yaddatrance/Laserpooper/PCB/PCBimage.png

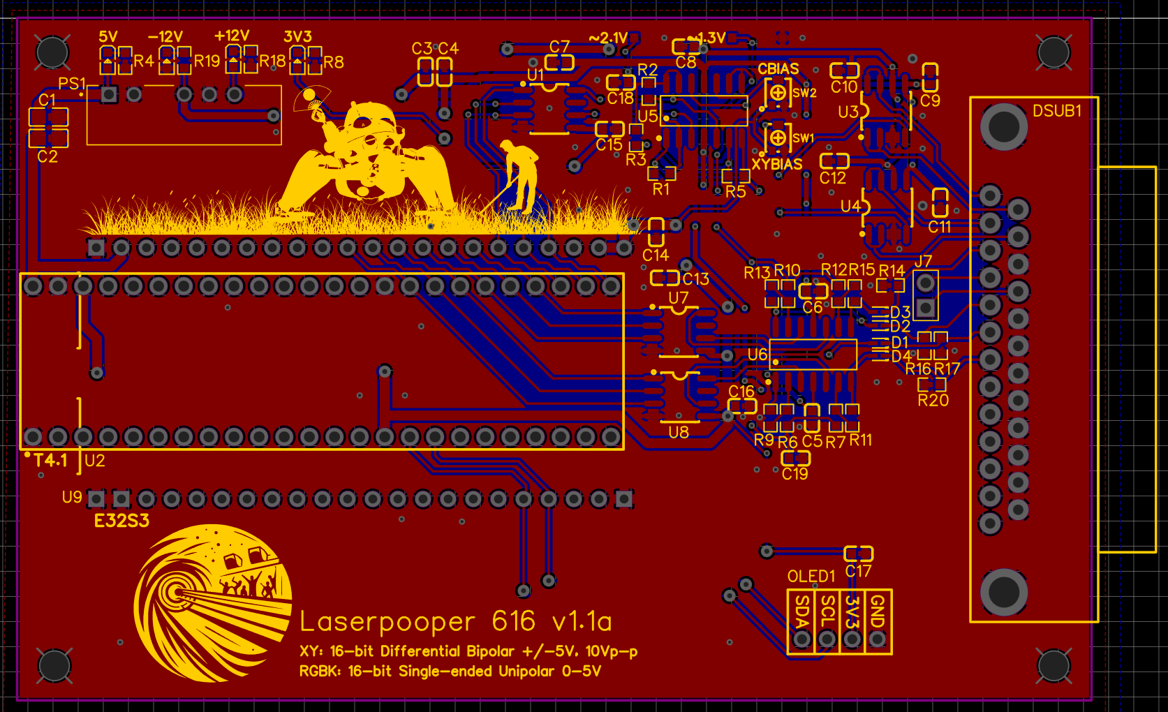
PCB/PCBimage.png
