yaddatrance/Laserpooper/PCB/BOM_ad5359b54c03457ea8222c665098385f.csv

ID | Name | Designator | Footprint | Quantity | Manufacturer Part | Manufacturer | Supplier | Supplier Part | Price | Contributor | link | 3DModel | JLCPCB Part Class
1 | 4.7u | C1,C2 | C0805 | 2 |  | muRata(村田) |  |  |  | LCEDA_Lib | https://item.szlcsc.com/373011.html | C0805_L2.0-W1.3-H1.3
2 | 1u | C3,C4 | C0603 | 2 |  | TAIYO YUDEN(太诱) |  |  |  | LCEDA_Lib | https://item.szlcsc.com/362304.html | C0603_L1.6-W0.8-H0.8
3 | 0.1u | C5,C6,C7,C8,C9,C10,C11,C12,C13,C14,C15,C16,C17 | C0603 | 13 |  | YAGEO(国巨) |  |  |  | LCEDA_Lib | https://item.szlcsc.com/362304.html | C0603_L1.6-W0.8-H0.8
4 | 0.1u | C18,C19 | C0603 | 2 |  |  |  |  |  | LCEDA_Lib | https://item.szlcsc.com/362304.html | C0603_L1.6-W0.8-H0.8
5 | 1N4148WT_C2892576 | D1,D2,D3,D4 | SOD-523_L1.2-W0.8-LS1.6-RD | 4 | 1N4148WT | YONGYUTAI(永裕泰) | LCSC | C2892576 |  | lcsc | https://item.szlcsc.com/10573.html | SOD-523_L1.2-W0.8-H0.7-LS1.6 | Extended Part
6 | 5747846-6 | DSUB1 | 5747846-6 | 1 | 5747846-6 | TE Connectivity | Mouser | 571-5747846-6 |  | rad_aci | https://www.mouser.de/ProductDetail/TE-Connectivity/5747846-6?qs=x6EjVpvqMVMeA4iw%2FpkEDQ%3D%3D
7 | INTERLOCK | J7 | HEADER1X2 | 1 |  | ZHOURI(洲日) |  |  |  | mrw42
8 | KT-0603R | LED1,LED2,LED3,LED4 | LED0603-RD | 4 | KT-0603R | KENTO | LCSC | C2286 |  | lcsc | https://item.szlcsc.com/347874.html | LED0603-RD | Basic Part
9 | 0.96OLED_4P_MODULE_JX | OLED1 | 0.96OLED_4P_KSON | 1 | 0.96OLED_4P_MODULE_JX | null | LCSC | C9900004566 |  | LCSC | https://cn.bing.com/search?q=datasheet：0.96OLED | 0.96OLED_4P | Extended Part
10 | PDME1-S5-D12-S | PS1 | CONV_PDME1-S5-D12-S | 1 |  | CUI Inc. |  |  |  | Dean Netherton
11 | 5.6kΩ | R1,R5 | R0603 | 2 | 0603WAF5601T5E | UNI-ROYAL(厚声) | LCSC | C23189 |  | lcsc | https://www.mouser.in/datasheet/2/447/PYu_RT_1_to_0_01_RoHS_L_11-1669912.pdf | R0603 | Basic Part
12 | 680Ω | R4 | R0603 | 1 | 0603WAF6800T5E | UNI-ROYAL(厚声) | LCSC | C23228 |  | lcsc | https://www.mouser.in/datasheet/2/447/PYu_RT_1_to_0_01_RoHS_L_11-1669912.pdf | R0603 | Basic Part
13 | 10kΩ | R6,R7,R10,R12 | R0603 | 4 | 0603WAF1002T5E | UNI-ROYAL(厚声) | LCSC | C25804 |  | lcsc | https://www.mouser.in/datasheet/2/447/PYu_RT_1_to_0_01_RoHS_L_11-1669912.pdf | R0603 | Basic Part
14 | 300Ω | R8 | R0603 | 1 | 0603WAF3000T5E | UNI-ROYAL(厚声) | LCSC | C23025 |  | lcsc | https://www.mouser.in/datasheet/2/447/PYu_RT_1_to_0_01_RoHS_L_11-1669912.pdf | R0603 | Basic Part
15 | 30kΩ | R9,R11,R13,R15 | R0603 | 4 | 0603WAF3002T5E | UNI-ROYAL(厚声) | LCSC | C22984 |  | lcsc | https://www.mouser.in/datasheet/2/447/PYu_RT_1_to_0_01_RoHS_L_11-1669912.pdf | R0603 | Basic Part
16 | 1kΩ | R2,R3,R14,R16,R17,R20 | R0603 | 6 | 0603WAF1001T5E | UNI-ROYAL(厚声) | LCSC | C21190 |  | lcsc | https://www.mouser.in/datasheet/2/447/PYu_RT_1_to_0_01_RoHS_L_11-1669912.pdf | R0603 | Basic Part
17 | 2.2kΩ | R18,R19 | R0603 | 2 | 0603WAF2201T5E | UNI-ROYAL(厚声) | LCSC | C4190 |  | lcsc | https://www.mouser.in/datasheet/2/447/PYu_RT_1_to_0_01_RoHS_L_11-1669912.pdf | R0603 | Basic Part
18 | 10kΩ | SW1,SW2 | RES-ADJ-SMD_3P-L2.8-W2.4-P1.25 | 2 | ST-2TA103 | NIDEC(尼得科) | LCSC | C2922056 |  | LCSC | https://www.mouser.com/datasheet/2/972/st_2-1827305.pdf | RES-ADJ-SMD_3P-L2.8-W2.4-P1.25 | Extended Part
19 | TEENSY USB BOARD, VERSION 4.1 | U2 | COMM-TH_L61.0-W17.8-P2.54 | 1 | Teensy USB Board, Version 4.1 | null | LCSC | C9900060513 |  | lcsc | https://www.pjrc.com/store/teensy41.html | COMM-TH_L61.0-W17.8-P2.54 | Extended Part
20 | DRV135UA/2K5 | U3,U4 | SOIC-8_L5.0-W4.0-P1.27-LS6.0-BL | 2 | DRV135UA/2K5 | Texas Instruments | LCSC | C544663 |  | Will Schoenfeld | https://item.szlcsc.com/417287.html | SOIC-8_L4.9-W3.9-H1.7-LS6.0-P1.27 | Extended Part
21 | TL074CDT | U5,U6 | SOIC-14_L8.7-W3.9-P1.27-LS6.0-BL | 2 | TL074CDT | ST(意法半导体) | LCSC | C6963 |  | lcsc | https://item.szlcsc.com/7253.html | SOIC-14_L8.6-W3.9-H1.8-LS6.0-P1.27 | Extended Part
22 | TM8211 | U1,U7,U8 | SOIC-8_L5.0-W4.0-P1.27-LS6.0-BL | 3 | TM8211 | TM(天微) | LCSC | C92003 |  | lcsc | https://item.szlcsc.com/417287.html | SOIC-8_L4.9-W3.9-H1.7-LS6.0-P1.27 | Extended Part
23 | ESP32-S3-DEVKITC-1 | U9 | ESP32-S3-DEVKITC-1-KENSONNOSILK | 1 |  |  |  |  |  | billo4th
