yaddatrance/Laserpooper/PCB/Schematic_DACAFTER_2024-07-10.pdf

# GND⁺⁵V

15 10 16 11 17 12 18 13 19 14 20 5V 21 G

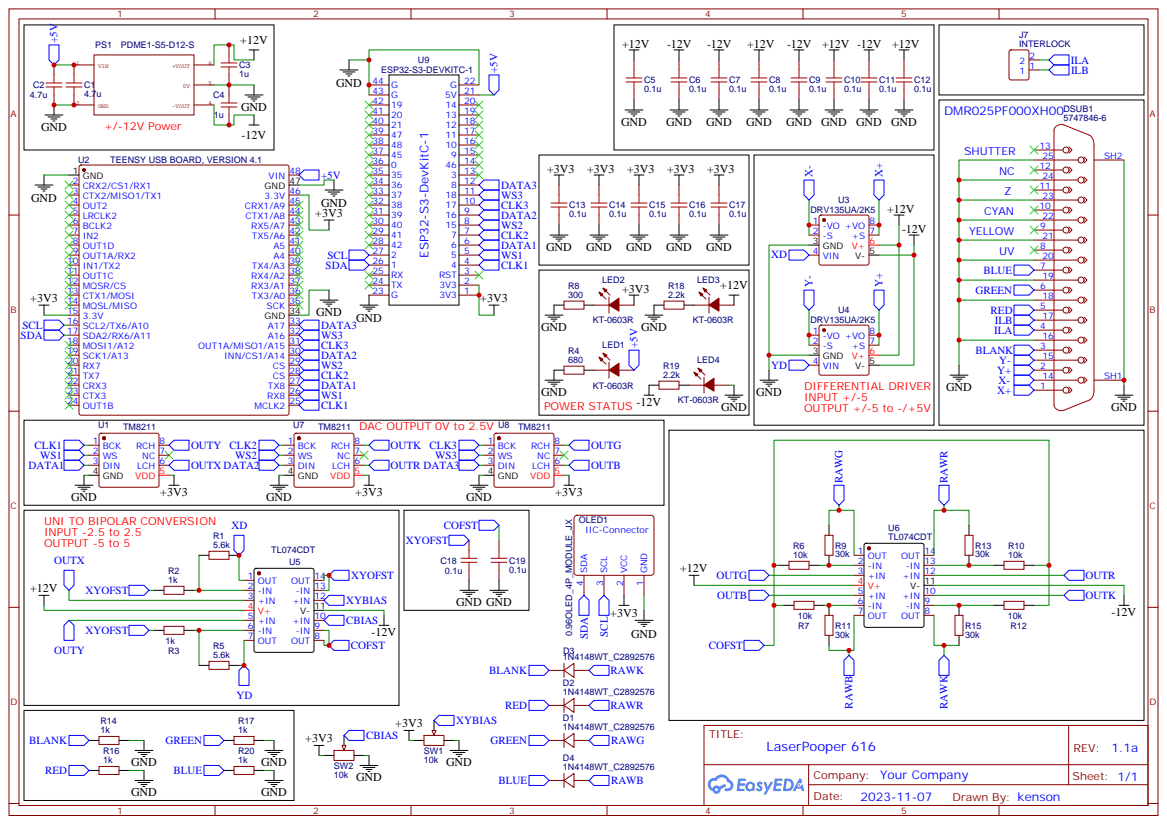
[picture p2: page 1]

UNI TO BIPOLAR CONVERSION
INPUT -2.5 to 2.5
OUTPUT -5 to 5
OUTX

+IN 10 V- 11 +IN 12 -IN 13 OUT 14
