yaddatrance/Laserpooper/(list of files, drawings)

Other design files:
PCB/EASYEDA_PCB_DACAFTER_2024-07-10.json
PCB/EASYEDA_SCHEMATIC_DACAFTER_2024-07-10.json
