yaddatrance/Laserpooper/Firmware/PinAssignments.h

#ifndef __PINASSIGNMENTS_H__
#define __PINASSIGNMENTS_H__

// DAC CODE
#define CLK1 33 // max 20Mhz (50ns), using 2x slower when HALFCLKns = 50
#define WS1 34
#define DATA1 35

#define CLK2 36 // max 20Mhz (50ns), using 2x slower when HALFCLKns = 50
#define WS2 37
#define DATA2 38

#define CLK3 39 // max 20Mhz (50ns), using 2x slower when HALFCLKns = 50
#define WS3 40
#define DATA3 41

#endif
